cedarhacks/HIDMorph/electrical/silkscreen_v5_01.jpg

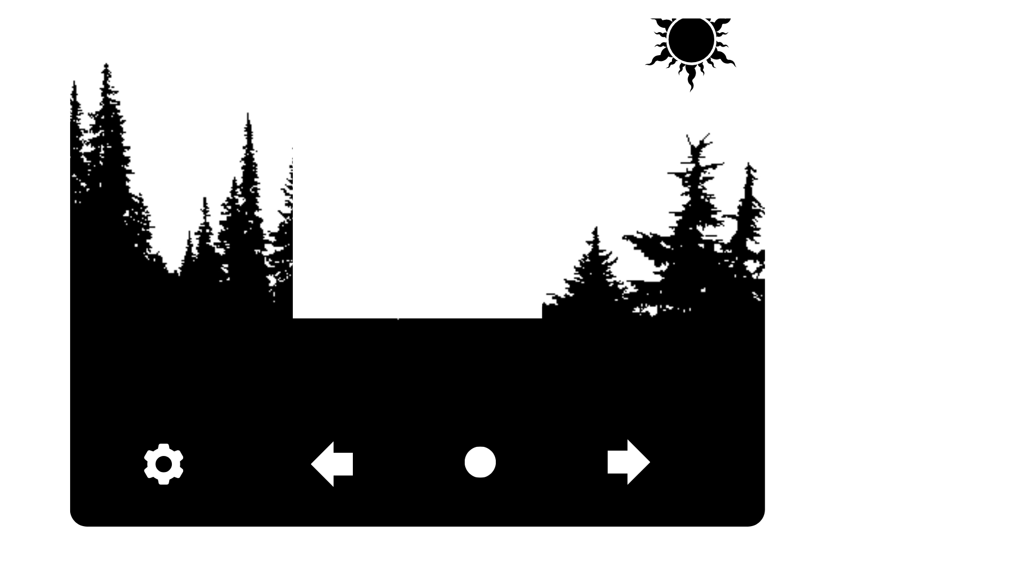
electrical/silkscreen_v5_01.jpg
