cedarhacks/HIDMorph/CH375B_breakout/BOM_CH37B Test Breakout_Schematic2_2025-04-11.xlsx

No. | Quantity | Comment | Designator | Footprint | Value | Manufacturer Part | Manufacturer | Supplier Part | Supplier
1 | 2 | PZ254-1-14-Z-8.5 | H1,H2 | HDR-TH_14P-P2.54-V-M |  | PZ254-1-14-Z-8.5 | HCTL(华灿天禄) | C2894937 | LCSC
2 | 1 | CH375B | U1 | SOIC-28_L17.9-W7.5-P1.27-LS10.3-BL |  | CH375B | WCH(南京沁恒) | C8962 | LCSC
