cedarhacks/HIDMorph/cad_files/screen_standoff.stl

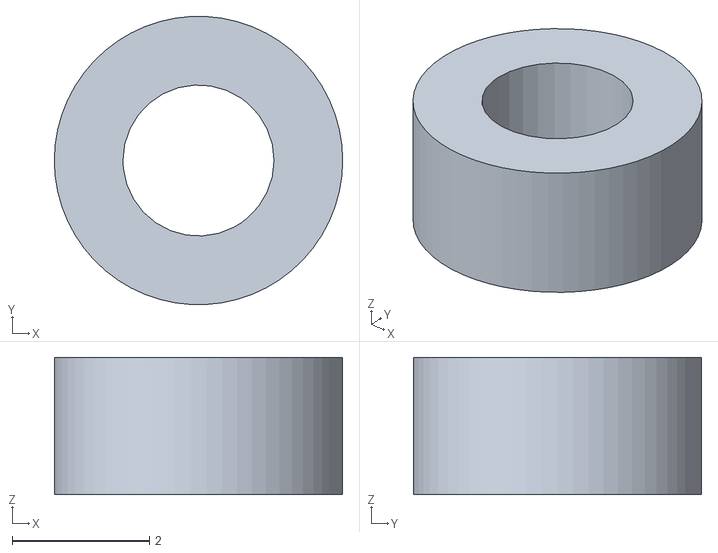
[picture p2: CAD file, 2026-01-06]
cad_files/screen_standoff.stl
4.20 x 4.19 x 2.00
