cedarhacks/HIDMorph/electrical/3D_models/ESP32-S3-WROOM-1-N8R8.STEP

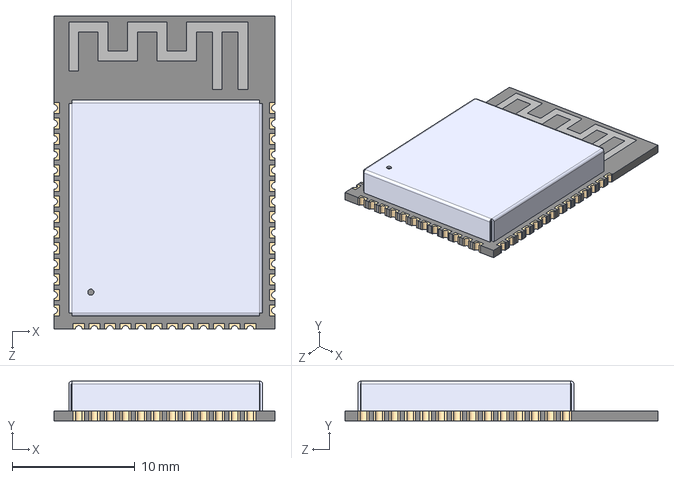
[picture p3: CAD file, 2025-07-15]
electrical/3D_models/ESP32-S3-WROOM-1-N8R8.STEP
18.0 x 3.25 x 25.5 mm
