cedarhacks/HIDMorph/electrical/edge_cut/v5.dxf

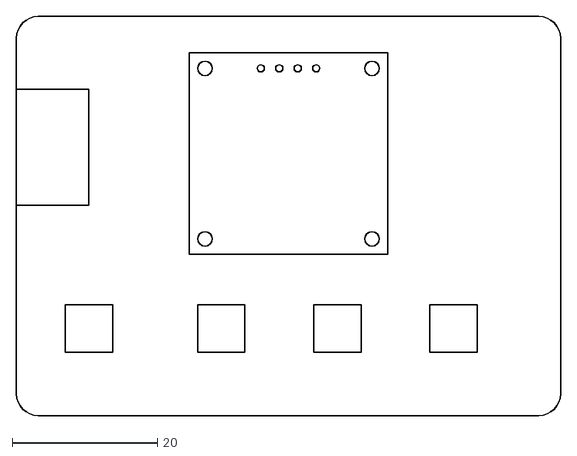
[picture p4: CAD file, 2025-12-17]
electrical/edge_cut/v5.dxf
75.0 x 55.0
