cedarhacks/HIDMorph/electrical/footprints/219-4MST.step

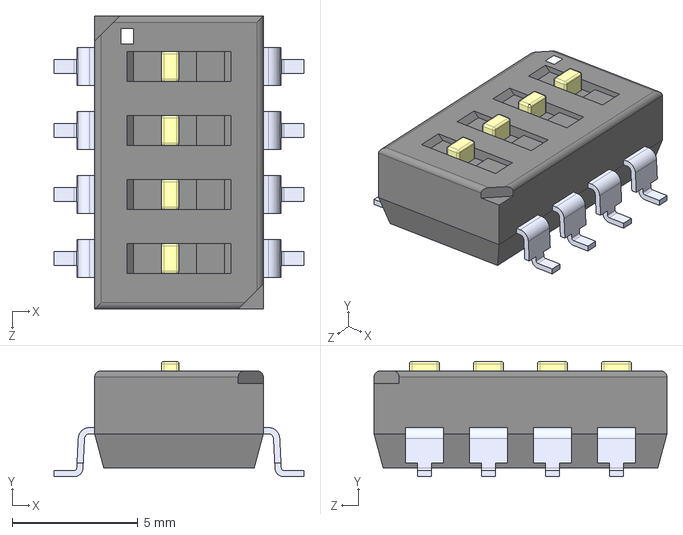
[picture p5: CAD file, 2025-12-18]
electrical/footprints/219-4MST.step
9.91 x 4.58 x 11.6 mm
