cedarhacks/HIDMorph/electrical/HIDMorph/ReMapper.step

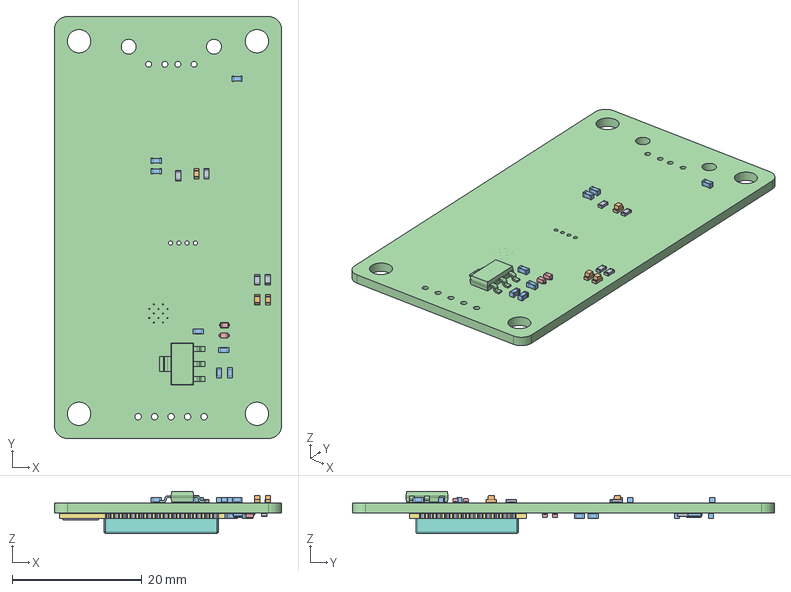
[picture p6: CAD file, 2025-10-05]
electrical/HIDMorph/ReMapper.step
35.0 x 65.0 x 6.48 mm
R_0603_1608Metric x 6
LED_0603_1608Metric x 3
C_0603_1608Metric x 14
SOT-223
D_SOD-523 x 4
ESP32-S3-WROOM-1
Crystal_SMD_3225-4Pin_3.2x2.5mm
ReMapper_PCB
