cedarhacks/HIDMorph/electrical/3D_models/RT6150B-33GQW.step

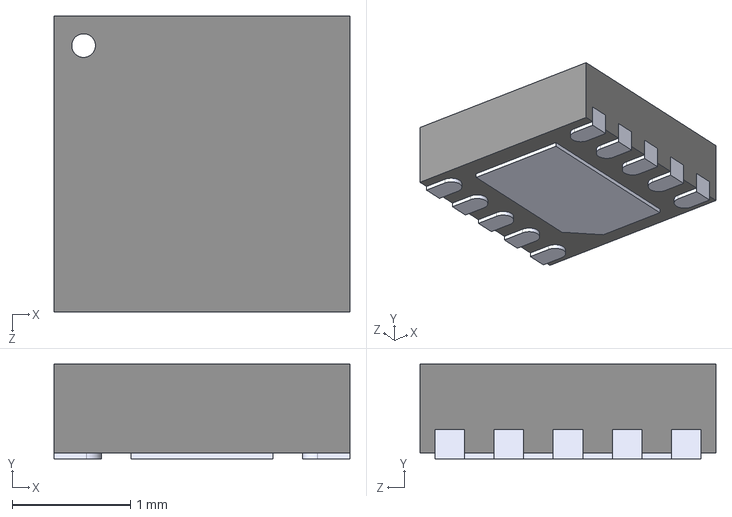
[picture p7: CAD file, 2025-07-15]
electrical/3D_models/RT6150B-33GQW.step
2.50 x 0.8 x 2.50 mm
