cedarhacks/HIDMorph/electrical/edge_cut/EdgeCut1.dxf

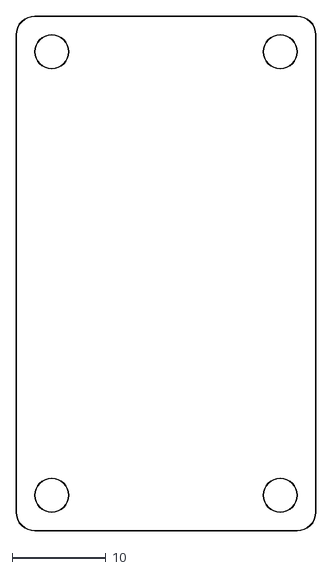
[picture p8: CAD file, 2025-09-18]
electrical/edge_cut/EdgeCut1.dxf
32.0 x 55.0
