cedarhacks/HIDMorph/electrical/footprints/SOT223-3_MXL.step

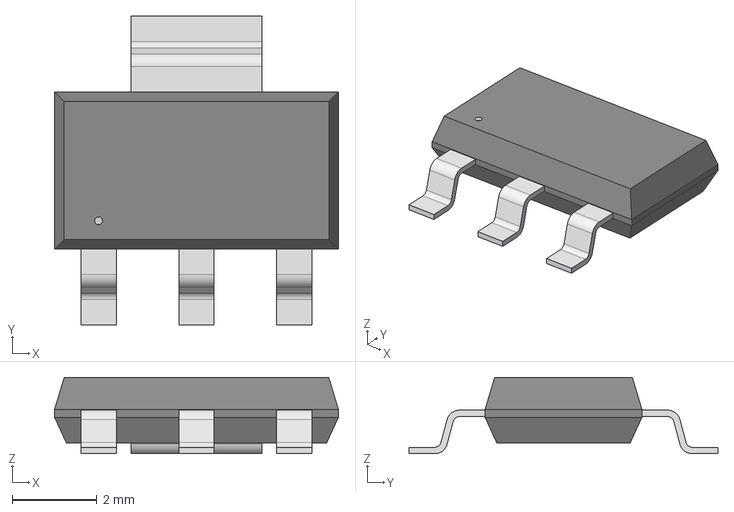
[picture p9: CAD file, 2025-07-15]
electrical/footprints/SOT223-3_MXL.step
6.71 x 7.29 x 1.81 mm
