cedarhacks/HIDMorph/electrical/3D_models/USBA_Female.step

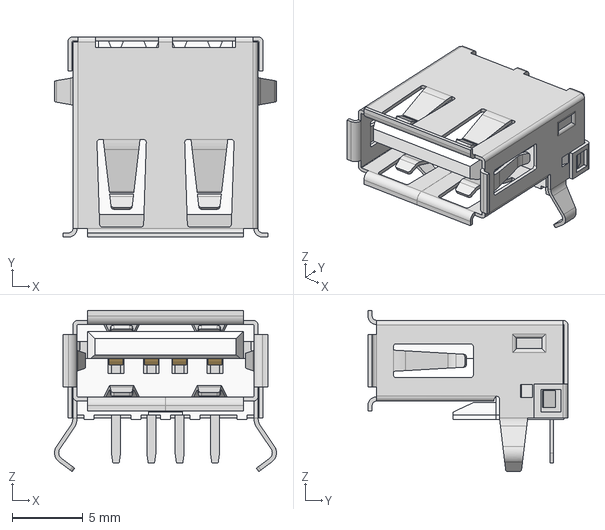
[picture p10: CAD file, 2025-07-15]
electrical/3D_models/USBA_Female.step
15.7 x 14.1 x 11.4 mm
614004190021_Shielding
