cedarhacks/HIDMorph/electrical/3D_models/push_button_SKRPABE010.step

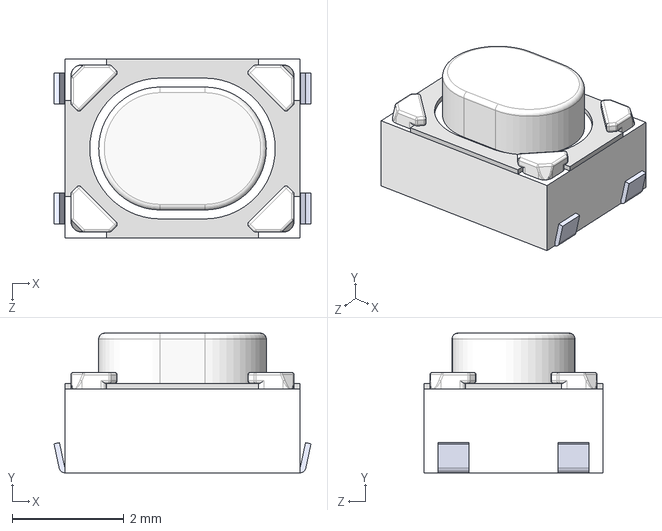
[picture p11: CAD file, 2025-07-15]
electrical/3D_models/push_button_SKRPABE010.step
4.60 x 2.50 x 3.20 mm
