cedarhacks/HIDMorph/electrical/3D_models/SC0914_13_.step

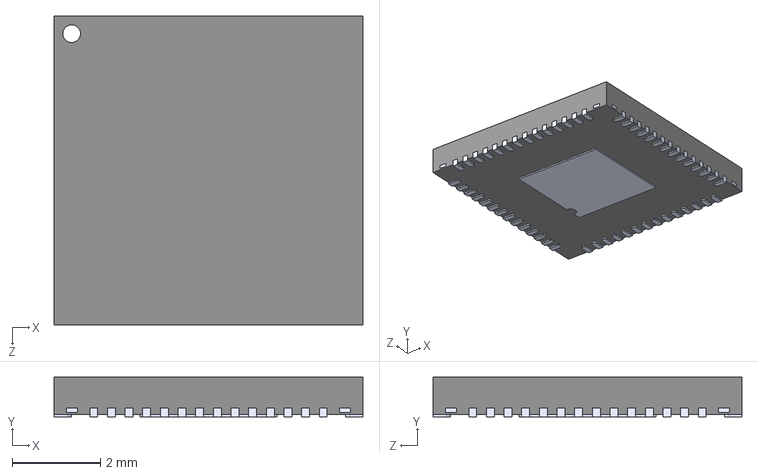
[picture p12: CAD file, 2025-07-15]
electrical/3D_models/SC0914_13_.step
7.00 x 0.9 x 7.00 mm
