cedarhacks/HIDMorph/electrical/HIDMorph/V2_schematic.pdf

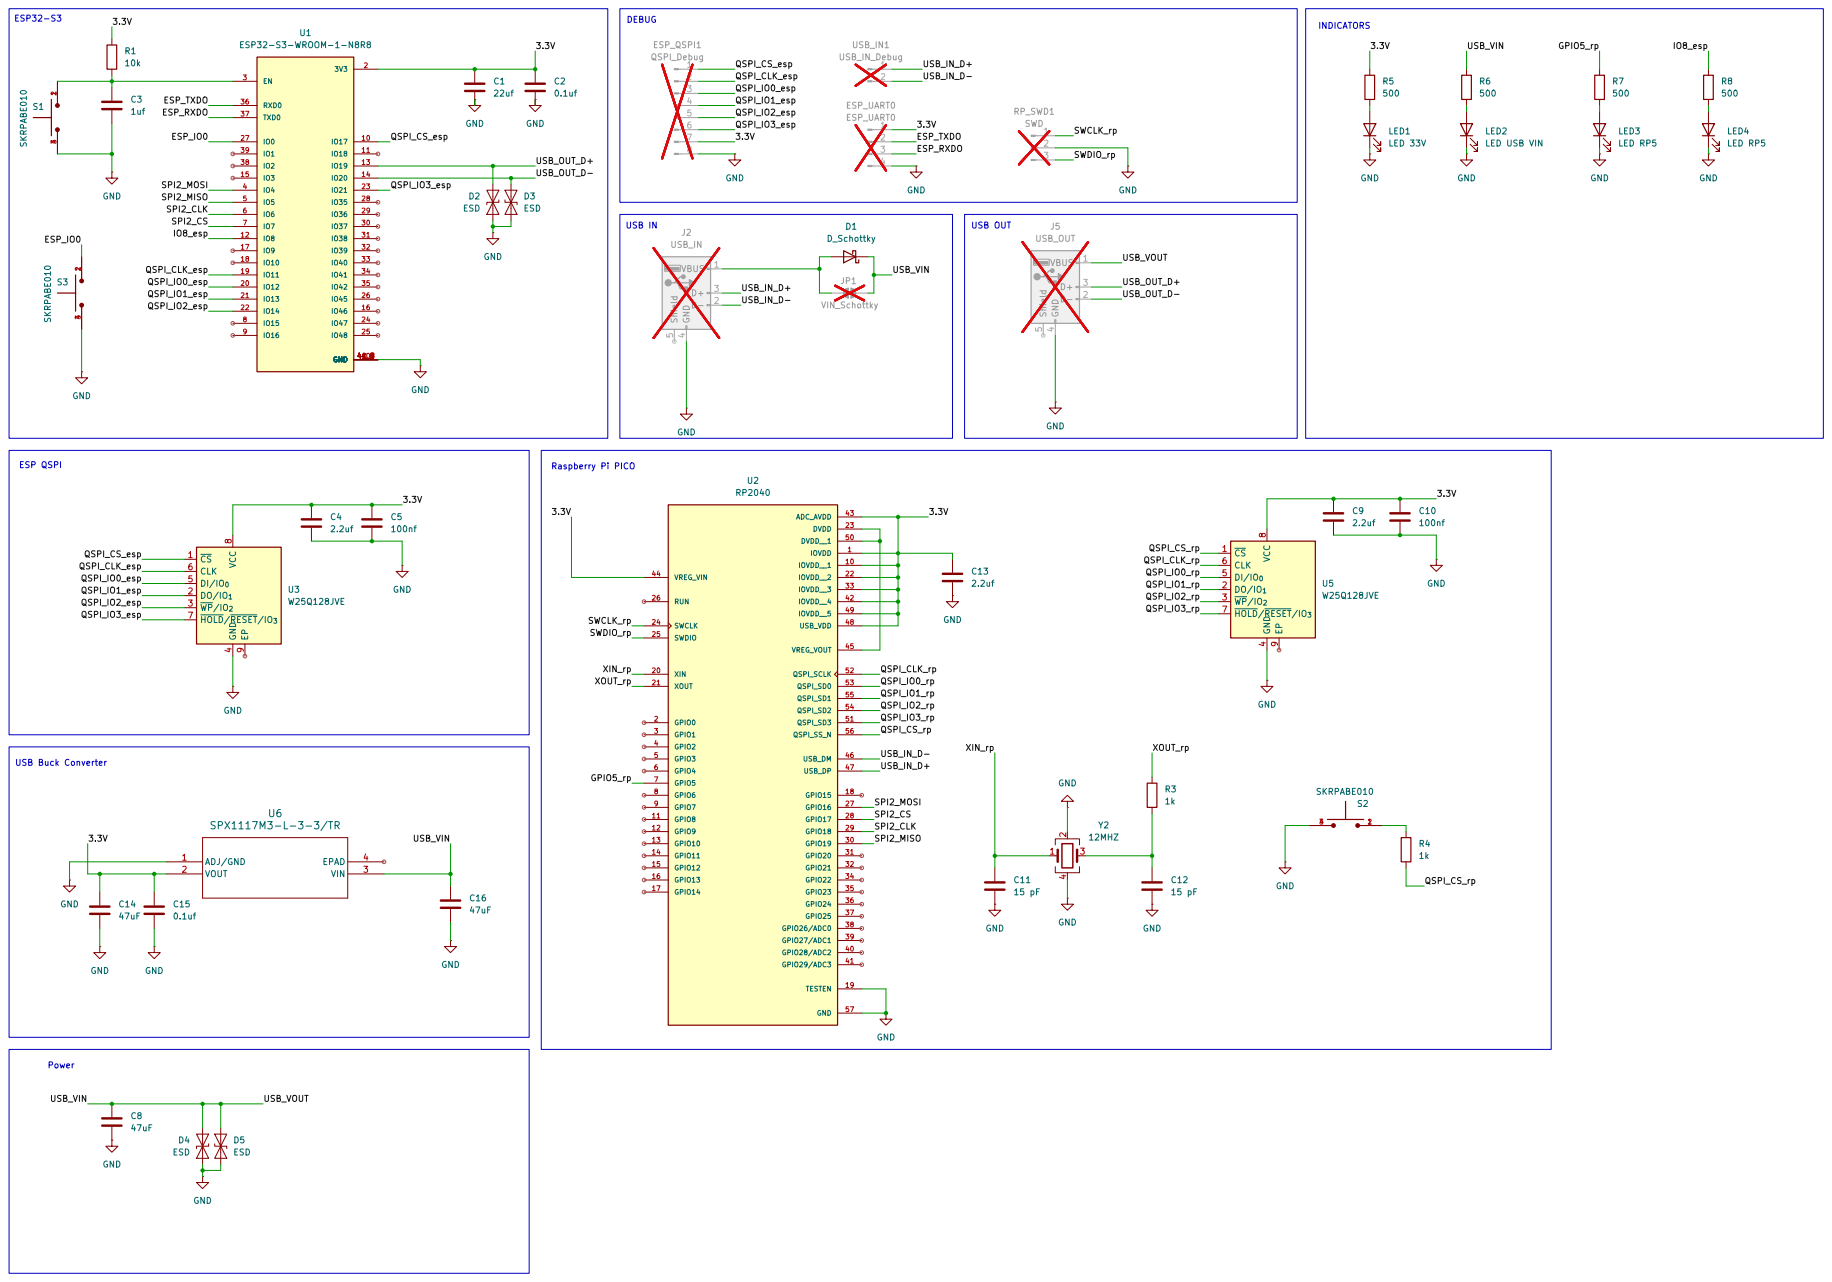
[picture p13: page 1]
