cedarhacks/HIDMorph/electrical/HIDMorph/assembly_map.pdf/HIDMorph-B_Cu.pdf

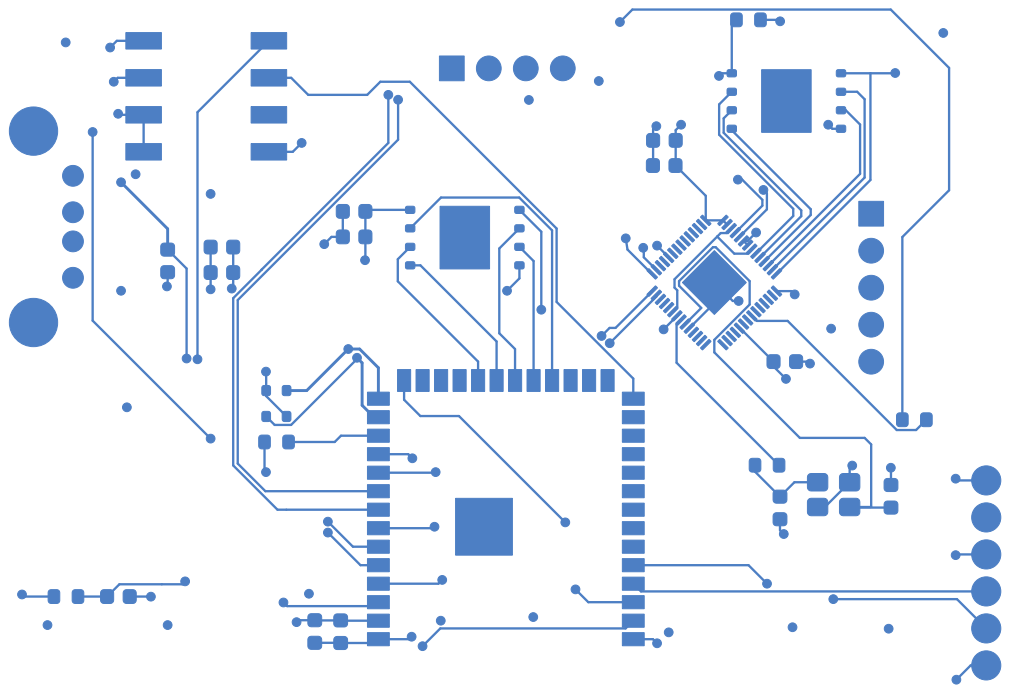
[picture p14: page 1]
