cedarhacks/HIDMorph/electrical/HIDMorph/assembly_map.pdf/HIDMorph-B_Mask.pdf

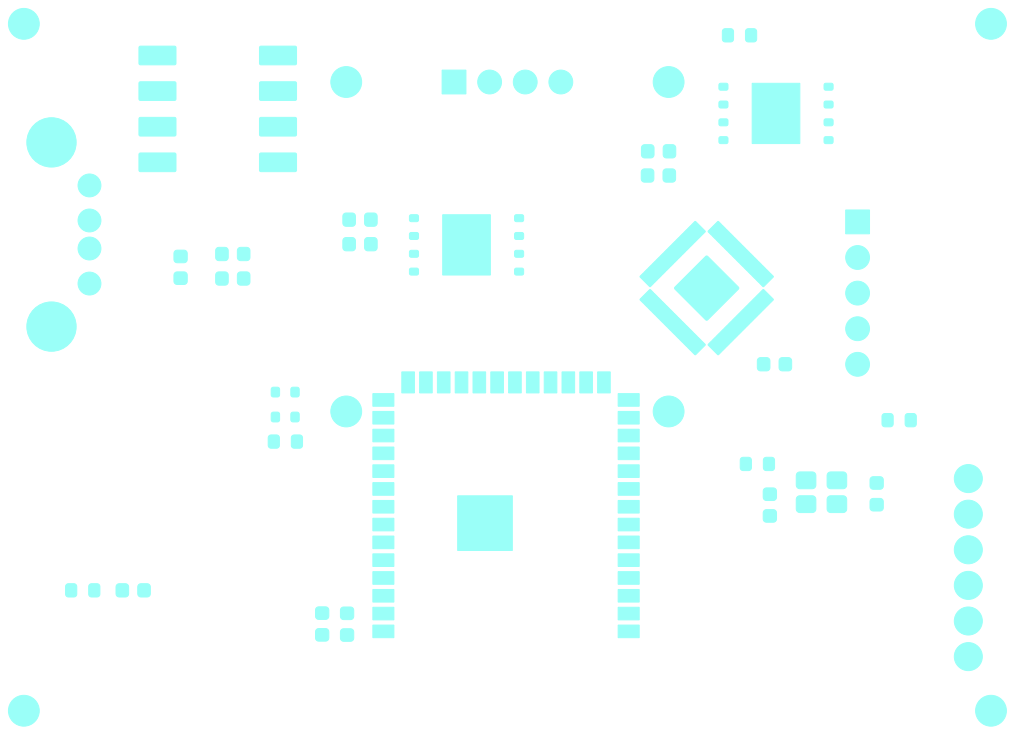
[picture p15: page 1]
