cedarhacks/HIDMorph/electrical/HIDMorph/assembly_map.pdf/HIDMorph-B_Paste.pdf

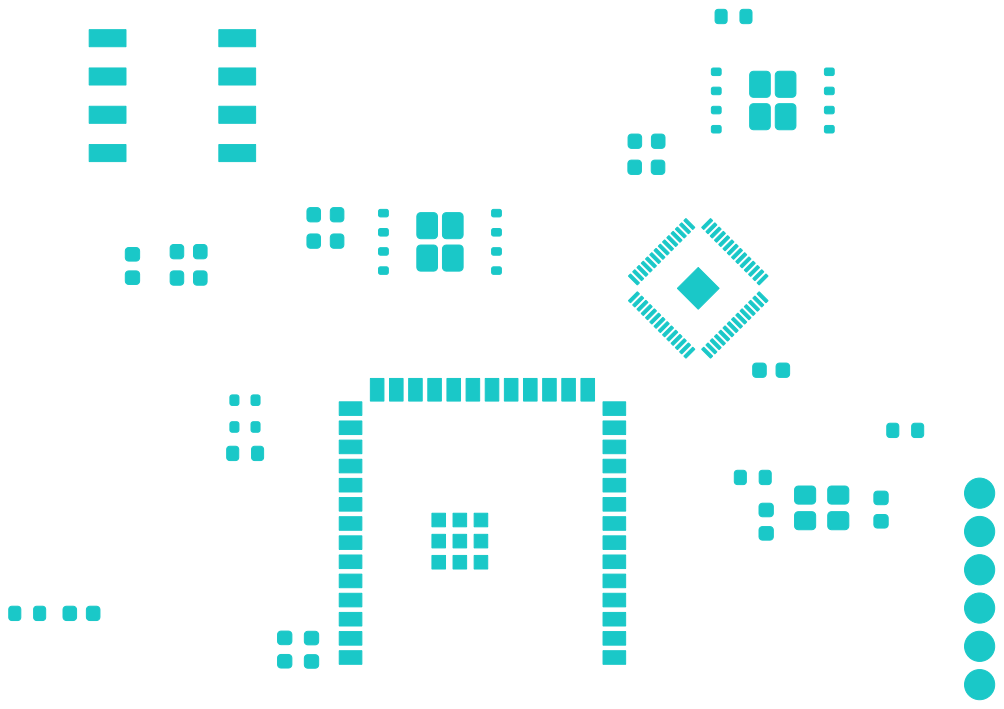
[picture p16: page 1]
