cedarhacks/HIDMorph/electrical/HIDMorph/assembly_map.pdf/HIDMorph-B_Silkscreen.pdf

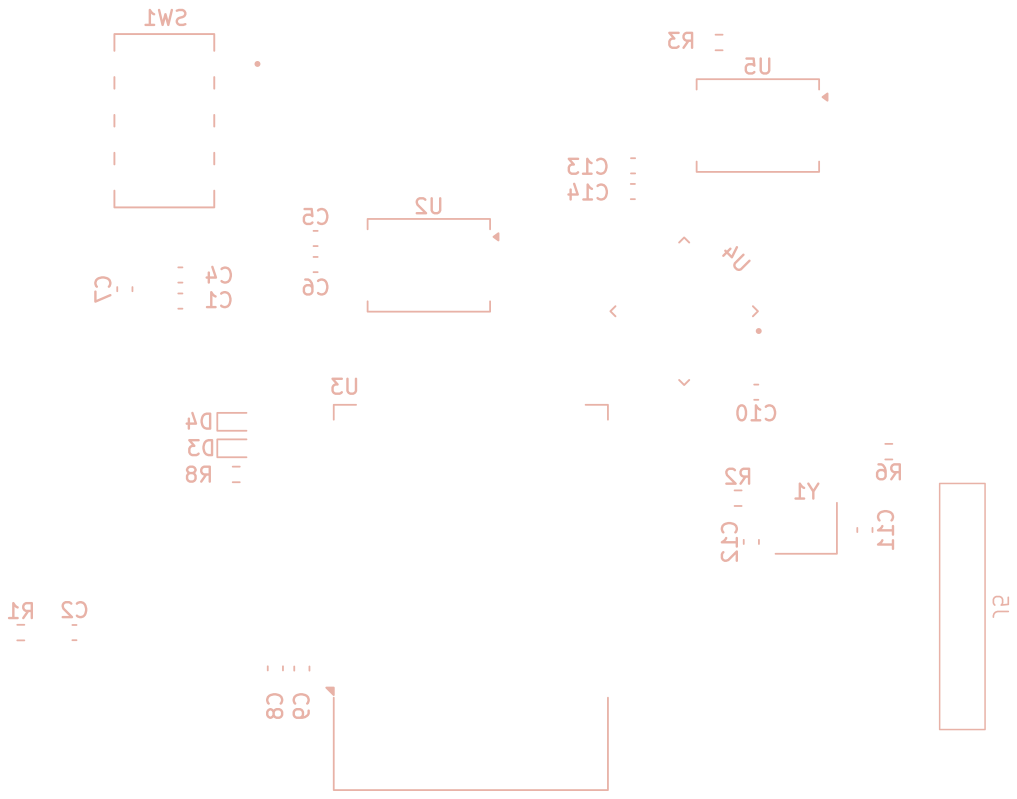
[picture p17: page 1]
