cedarhacks/HIDMorph/electrical/HIDMorph/assembly_map.pdf/HIDMorph-Edge_Cuts.pdf

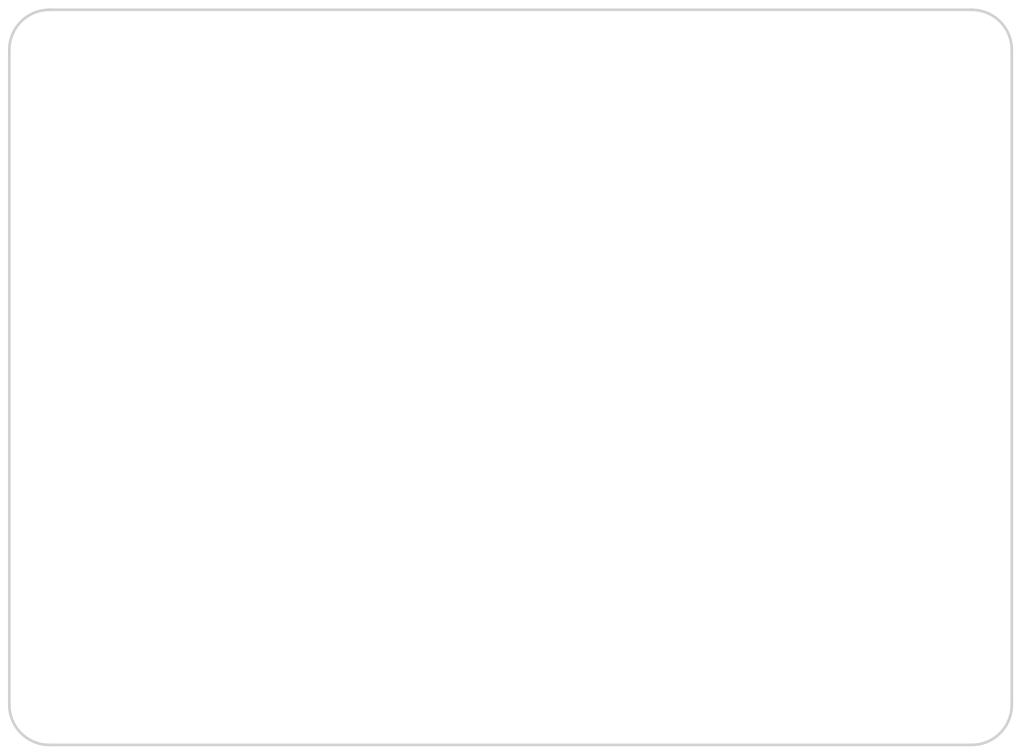
[picture p18: page 1]
