cedarhacks/HIDMorph/electrical/HIDMorph/V2_layout.pdf

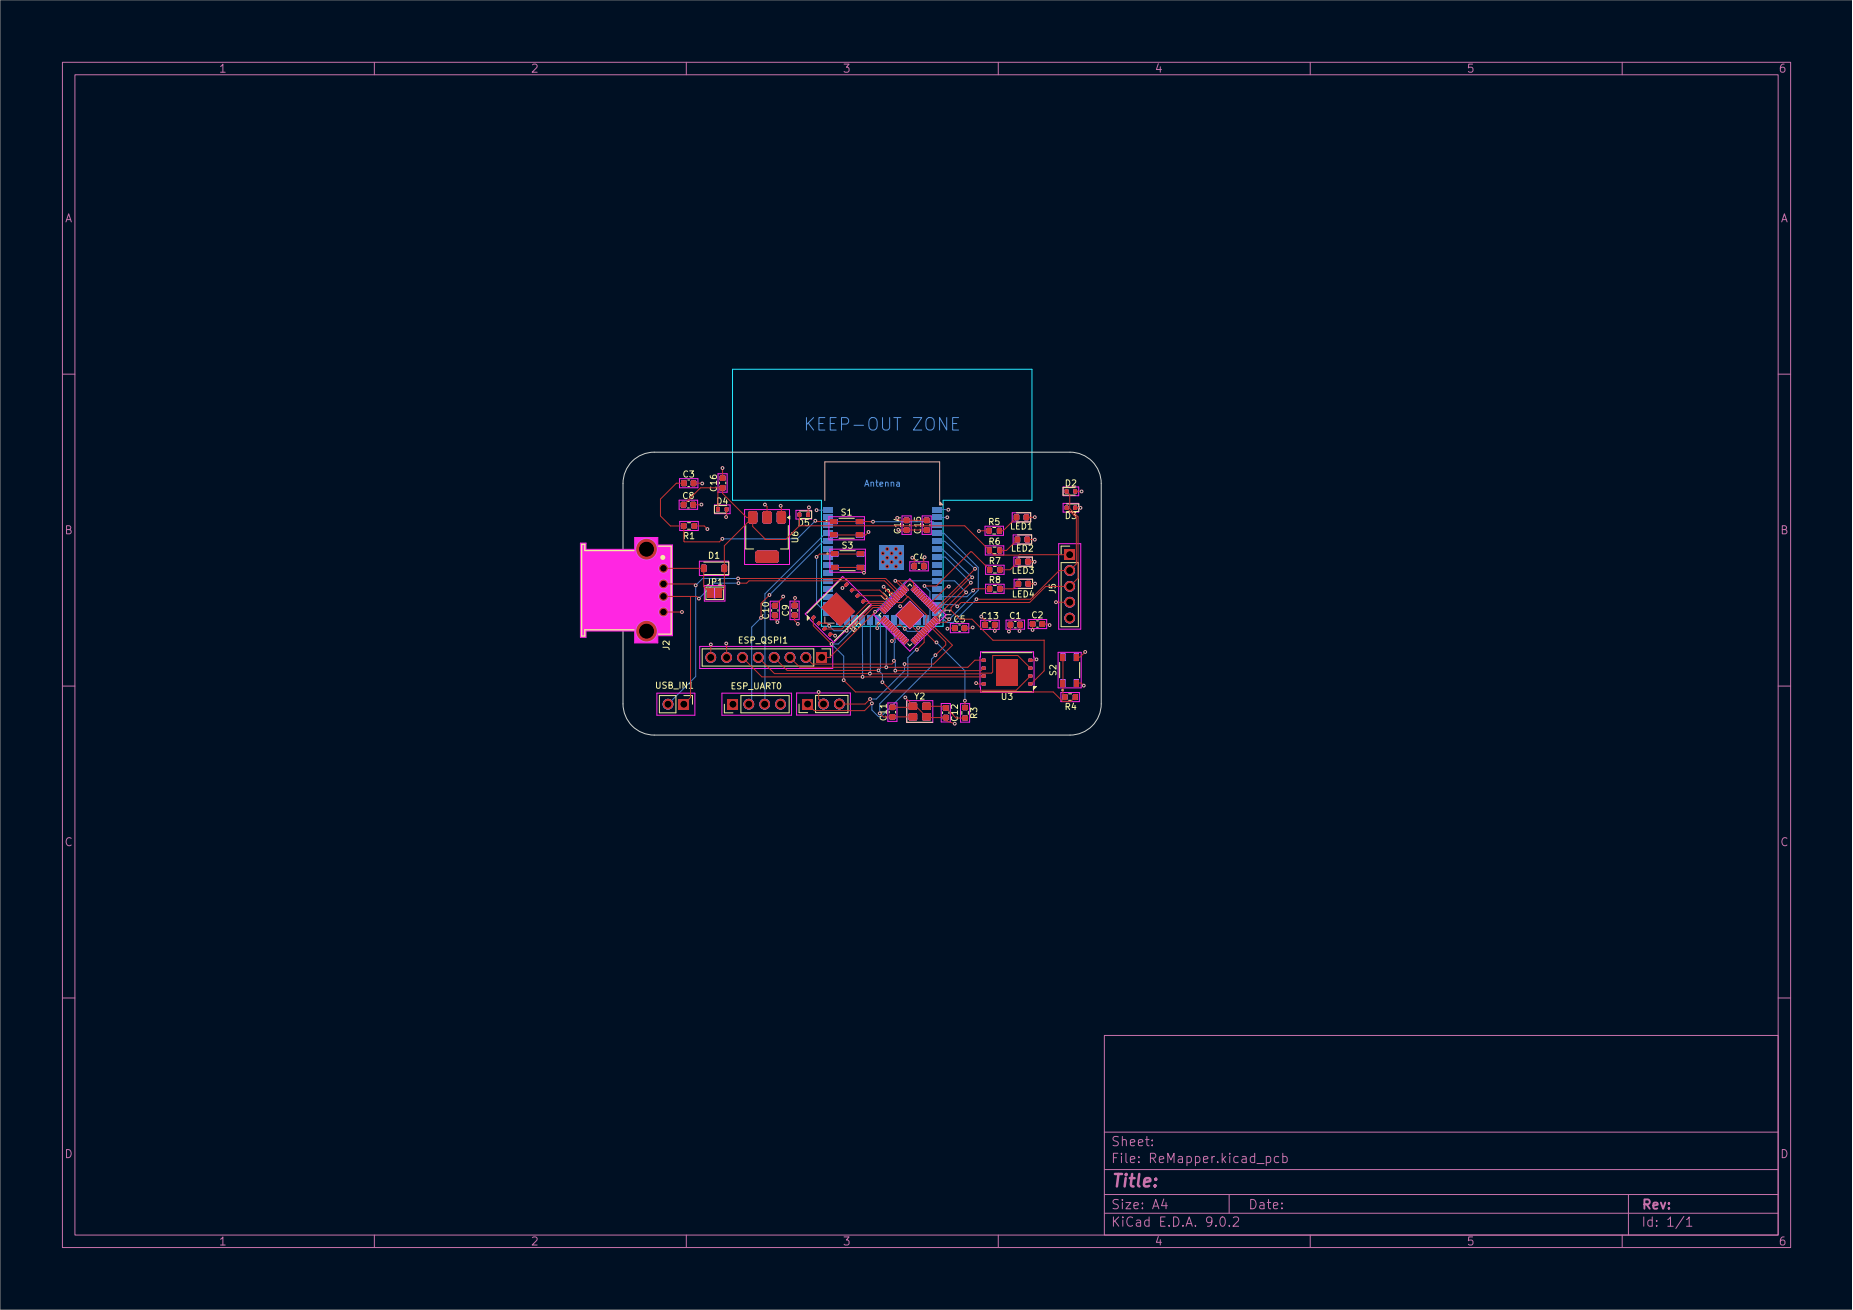
[picture p19: page 1]
