cedarhacks/HIDMorph/(list of files, drawings)

Other design files:
CH375B_breakout/KeyStick_2025-04-11.epro
HT42B564-Breakout/HT42B564-breakout.epro
