cedarhacks/HIDMorph/electrical/HIDMorph/HIDMorph.kicad_pcb

## KiCad design electrical/HIDMorph/HIDMorph.kicad_pcb (2026-01-06)

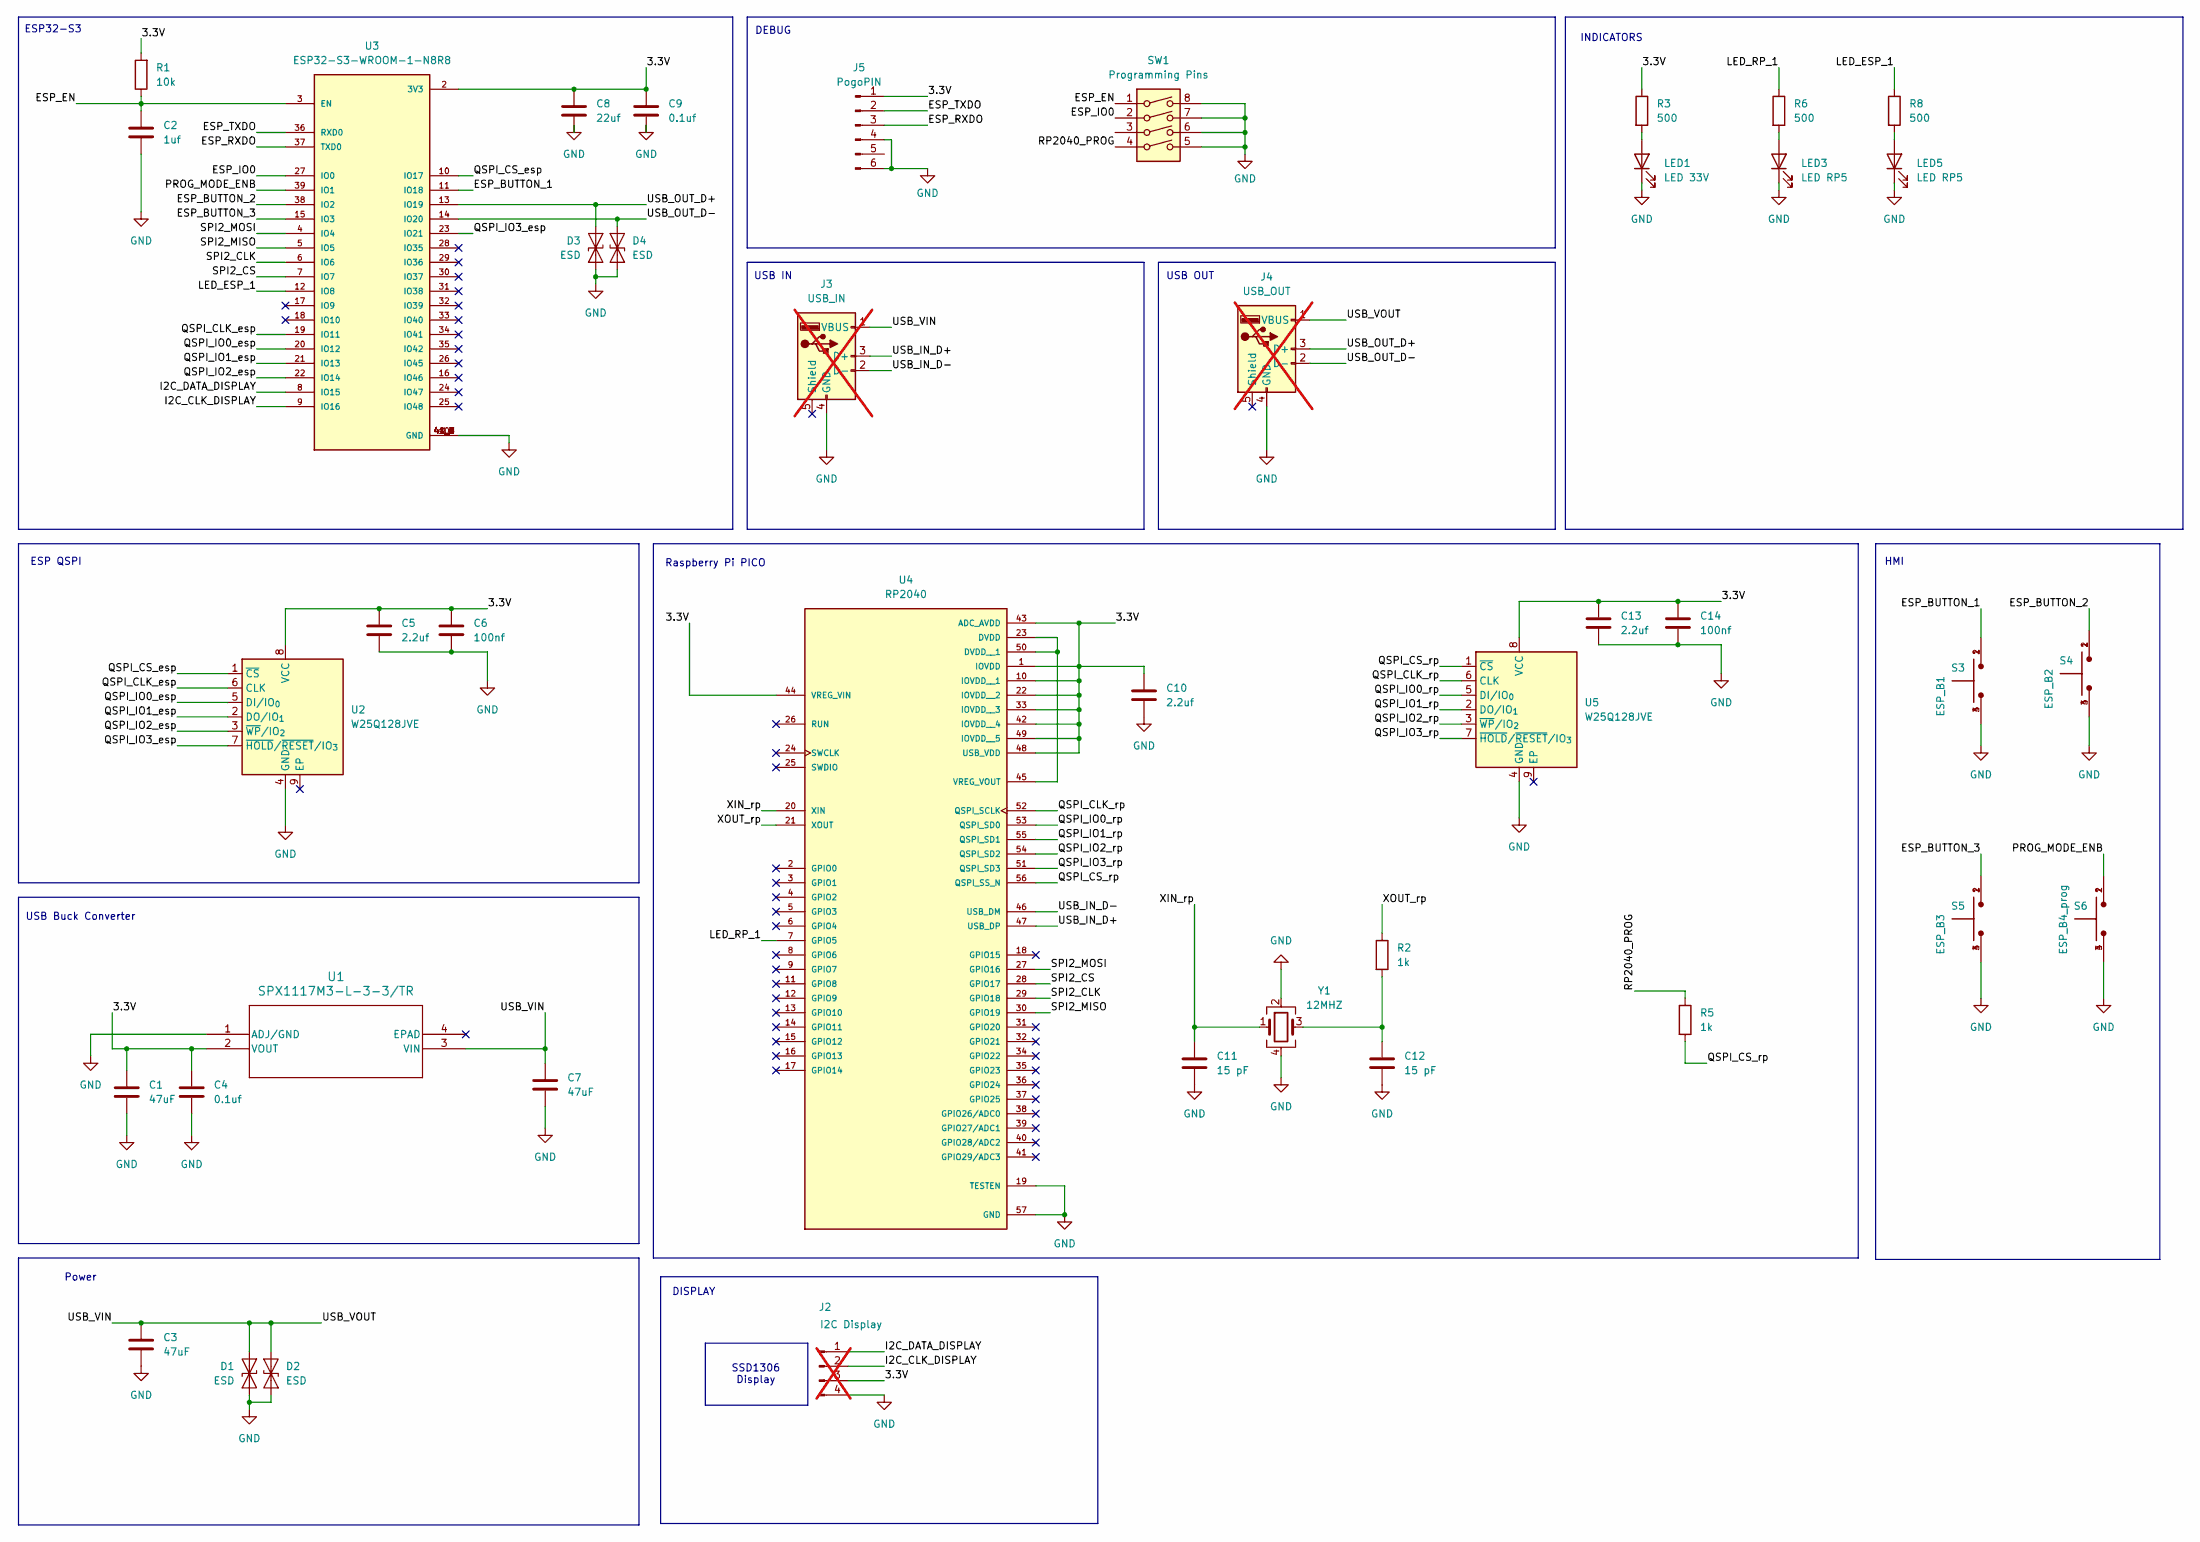
[picture p20: schematic HIDMorph.kicad_sch]

Parts:
C1, C3, C7: 47uF; C_0603_1608Metric; LCSC Part C140782
C2: 1uf; C_0603_1608Metric; LCSC Part C5189821
C4, C9: 0.1uf; C_0603_1608Metric; LCSC Part C14663
C5, C10, C13: 2.2uf; C_0603_1608Metric; LCSC Part C5189830
C6, C14: 100nf; C_0603_1608Metric; LCSC Part C5189821
C8: 22uf; C_0603_1608Metric; LCSC Part C48579267
C11, C12: 15 pF; C_0603_1608Metric; LCSC Part C107037
D1, D2, D3, D4: ESD; D_SOD-523; LCSC Part C5199159
J2: I2C Display; PinHeader_1x04_P2.54mm_Vertical; not fitted
J3: USB_IN; USBA_Female; not fitted
J4: USB_OUT; PinHeader_1x05_P2.54mm_Vertical; not fitted
J5: PogoPIN; pogo_pin_2.54mm
LED1: LED 33V; LED_0603_1608Metric; LCSC Part C965807
LED3, LED5: LED RP5; LED_0603_1608Metric; LCSC Part C965807
R1: 10k; R_0603_1608Metric; LCSC Part C98220
R2, R5: 1k; R_0603_1608Metric; LCSC Part C22548
R3, R6, R8: 500; R_0603_1608Metric; LCSC Part C860931
S3: ESP_B1; SW-SMD_4P-L4.5-W4.5-P3.00-LS6.8; LCSC Part C2837554
S4: ESP_B2; SW-SMD_4P-L4.5-W4.5-P3.00-LS6.8; LCSC Part C2837554
S5: ESP_B3; SW-SMD_4P-L4.5-W4.5-P3.00-LS6.8; LCSC Part C2837554
S6: ESP_B4_prog; SW-SMD_4P-L4.5-W4.5-P3.00-LS6.8; LCSC Part C2837554
SW1: Programming Pins; SW_DIP_219-4
U1: SPX1117M3-L-3-3/TR; SOT-223; LCSC Part C6862
U2, U5: W25Q128JVE; WSON-8-1EP_8x6mm_P1.27mm_EP3.4x4.3mm; LCSC Part C401662
U3: ESP32-S3-WROOM-1-N8R8; ESP32-S3-WROOM-1; LCSC Part C2913201
U4: RP2040; rp2040; PARTREV 2.2; LCSC Part C2040
Y1: 12MHZ; Crystal_SMD_3225-4Pin_3.2x2.5mm; LCSC Part C9002

Connections:
/3.3V: C1.1, C4.1, C5.1, C6.1, C8.1, C9.1, C10.1, C13.1, C14.1, J2.3, J5.1, R1.2, R3.1, U1.2 (VOUT), U2.8 (VCC), U3.2 (3V3), U4.1 (IOVDD), U4.10 (IOVDD__1), U4.22 (IOVDD__2), U4.33 (IOVDD__3), U4.42 (IOVDD__4), U4.43 (ADC_AVDD), U4.44 (VREG_VIN), U4.48 (USB_VDD), U4.49 (IOVDD__5), U5.8 (VCC)
/ESP_BUTTON_1: S3.1, S3.2, U3.11 (IO18)
/ESP_BUTTON_2: S4.1, S4.2, U3.38 (IO2)
/ESP_BUTTON_3: S5.1, S5.2, U3.15 (IO3)
/ESP_EN: C2.1, R1.1, SW1.1, U3.3 (EN)
/ESP_IO0: SW1.2, U3.27 (IO0)
/ESP_RXDO: J5.3, U3.37 (TXD0)
/ESP_TXDO: J5.2, U3.36 (RXD0)
/I2C_CLK_DISPLAY: J2.2, U3.9 (IO16)
/I2C_DATA_DISPLAY: J2.1, U3.8 (IO15)
/LED_ESP_1: R8.1, U3.12 (IO8)
/LED_RP_1: R6.1, U4.7 (GPIO5)
/PROG_MODE_ENB: S6.1, S6.2, U3.39 (IO1)
/QSPI_CLK_esp: U2.6 (CLK), U3.19 (IO11)
/QSPI_CLK_rp: U4.52 (QSPI_SCLK), U5.6 (CLK)
/QSPI_CS_esp: U2.1 (~CS), U3.10 (IO17)
/QSPI_CS_rp: R5.2, U4.56 (QSPI_SS_N), U5.1 (~CS)
/QSPI_IO0_esp: U2.5 (DI/IO_{0}), U3.20 (IO12)
/QSPI_IO0_rp: U4.53 (QSPI_SD0), U5.5 (DI/IO_{0})
/QSPI_IO1_esp: U2.2 (DO/IO_{1}), U3.21 (IO13)
/QSPI_IO1_rp: U4.55 (QSPI_SD1), U5.2 (DO/IO_{1})
/QSPI_IO2_esp: U2.3 (~WP/IO_{2}), U3.22 (IO14)
/QSPI_IO2_rp: U4.54 (QSPI_SD2), U5.3 (~WP/IO_{2})
/QSPI_IO3_esp: U2.7 (~HOLD/~RESET/IO_{3}), U3.23 (IO21)
/QSPI_IO3_rp: U4.51 (QSPI_SD3), U5.7 (~HOLD/~RESET/IO_{3})
/RP2040_PROG: R5.1, SW1.4
/SPI2_CLK: U3.6 (IO6), U4.29 (GPIO18)
/SPI2_CS: U3.7 (IO7), U4.28 (GPIO17)
/SPI2_MISO: U3.5 (IO5), U4.30 (GPIO19)
/SPI2_MOSI: U3.4 (IO4), U4.27 (GPIO16)
/USB_IN_D+: J3.3 (D+), U4.47 (USB_DP)
/USB_IN_D-: J3.2 (D-), U4.46 (USB_DM)
/USB_OUT_D+: D3.1 (A1), J4.3 (D+), U3.13 (IO19)
/USB_OUT_D-: D4.2 (A2), J4.2 (D-), U3.14 (IO20)
/USB_VIN: C3.1, C7.1, D1.1 (A1), D2.2 (A2), J3.1 (VBUS), J4.1 (VBUS), U1.3 (VIN)
/XIN_rp: C11.1, U4.20 (XIN), Y1.1
/XOUT_rp: R2.1, U4.21 (XOUT)
GND: C1.2, C2.2, C3.2, C4.2, C5.2, C6.2, C7.2, C8.2, C9.2, C10.2, C11.2, C12.2, C13.2, C14.2, D1.2 (A2), D2.1 (A1), D3.2 (A2), D4.1 (A1), J2.4, J3.4 (GND), J4.4 (GND), J5.4, J5.6, LED1.1 (K), LED3.1 (K), LED5.1 (K), S3.3, S3.4, S4.3, S4.4, S5.3, S5.4, S6.3, S6.4, SW1.5, SW1.6, SW1.7, SW1.8, U1.1 (ADJ/GND), U2.4 (GND), U3.1 (GND), U3.40 (GND), U3.41_1 (GND), U3.41_2 (GND), U3.41_3 (GND), U3.41_4 (GND), U3.41_5 (GND), U3.41_6 (GND), U3.41_7 (GND), U3.41_8 (GND), U3.41_9 (GND), U4.19 (TESTEN), U4.57 (GND), U5.4 (GND), Y1.2, Y1.4
unnamed: C12.1, R2.2, Y1.3
unnamed: LED1.2 (A), R3.2
unnamed: LED3.2 (A), R6.2
unnamed: LED5.2 (A), R8.2
unnamed: U4.23 (DVDD), U4.45 (VREG_VOUT), U4.50 (DVDD__1)

Notes on the sheet:
INDICATORS
USB IN
DISPLAY
ESP QSPI
USB Buck Converter
Power
USB OUT
Raspberry Pi PICO
ESP32-S3
HMI
SSD1306 Display
DEBUG

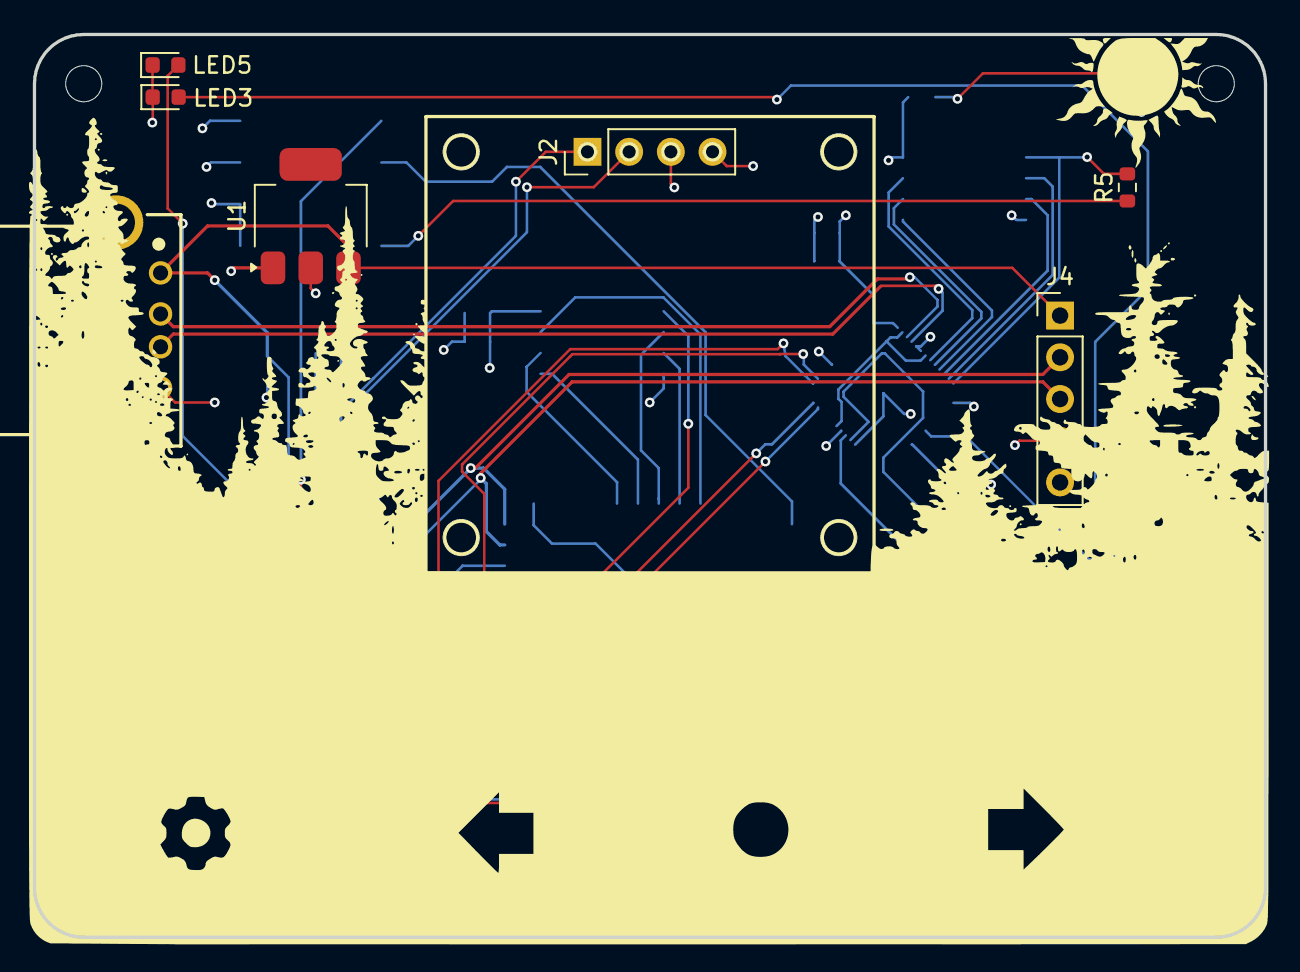
[picture p21: board HIDMorph.kicad_pcb from above]

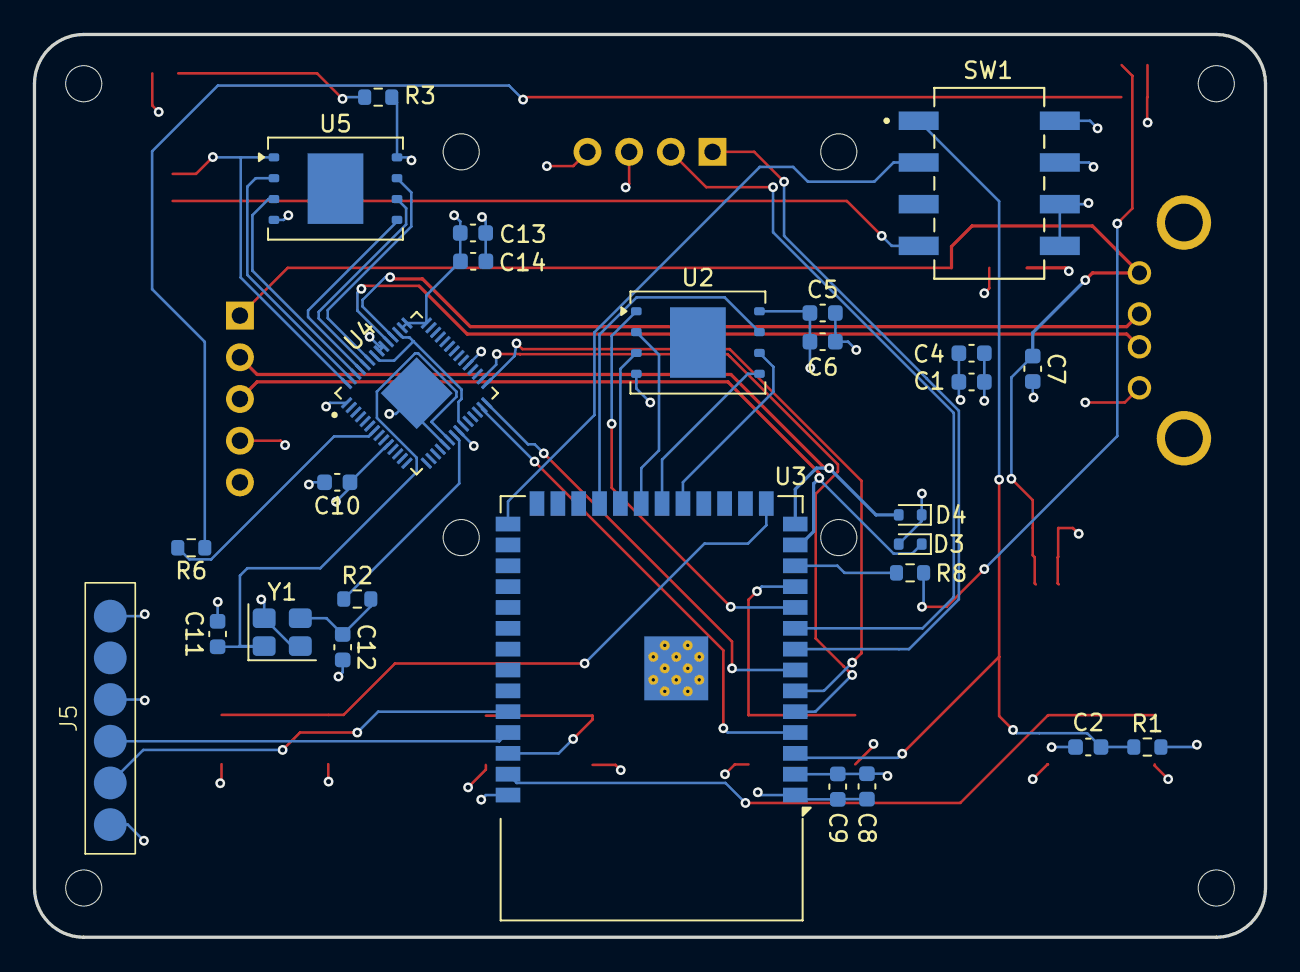
[picture p22: board HIDMorph.kicad_pcb from below]

Board: 4 copper layers, 75.0 x 55.0 mm, 42 parts (27 on the bottom side), 43 nets.
