cedarhacks/HIDMorph/software/ESP32/HIDMorph/main/src/webserver.c

#include "webserver.h"

#include <string.h>

#include "lwip/sockets.h"
#include "lwip/netdb.h"
#include "lwip/inet.h"
#include "esp_log.h"

#define DNS_PORT 53
#define DNS_BUFFER_SIZE 512
int dns_sock;

extern const uint8_t _binary_index_html_start[];
extern const uint8_t _binary_index_html_end[];

extern const uint8_t _binary_style_css_start[];
extern const uint8_t _binary_style_css_end[];

void start_access_point() {

    // Initialize NVS
    ESP_ERROR_CHECK(nvs_flash_init());
    ESP_ERROR_CHECK(esp_netif_init());
    ESP_ERROR_CHECK(esp_event_loop_create_default());

    esp_netif_create_default_wifi_ap();

    wifi_init_config_t cfg = WIFI_INIT_CONFIG_DEFAULT();
    ESP_ERROR_CHECK(esp_wifi_init(&cfg));

    wifi_config_t wifi_config = {
        .ap = {
            .ssid = AP_SSID,
            .ssid_len = strlen(AP_SSID),
            .password = AP_PASSWD,
            .max_connection = 4,
            .authmode = WIFI_AUTH_WPA_WPA2_PSK},
    };

    // no auth
    wifi_config.ap.authmode = WIFI_AUTH_OPEN;

    ESP_ERROR_CHECK(esp_wifi_set_mode(WIFI_MODE_AP));
    ESP_ERROR_CHECK(esp_wifi_set_config(WIFI_IF_AP, &wifi_config));
    ESP_ERROR_CHECK(esp_wifi_start());

    ESP_LOGI("WIFI", "Wifi network started: %s\n", AP_SSID);
}

// -------------------------------------------------------------------------------------

esp_err_t root_get_handler(httpd_req_t *req) {
    const char *resp_str = (char*)_binary_index_html_start;
    httpd_resp_send(req, resp_str, HTTPD_RESP_USE_STRLEN);
    return ESP_OK;
}

esp_err_t style_get_handler(httpd_req_t *req) {
    const char *resp_str = (char*)_binary_style_css_start;
    httpd_resp_send(req, resp_str, HTTPD_RESP_USE_STRLEN);
    return ESP_OK;
}

void start_webserver() {
    httpd_config_t config = HTTPD_DEFAULT_CONFIG();

    httpd_handle_t server = NULL;

    httpd_uri_t uri_root = {.uri = "/",
                            .method = HTTP_GET,
                            .handler = root_get_handler,
                            .user_ctx = NULL};

    httpd_uri_t uri_style = {.uri = "/style.css",
                             .method = HTTP_GET,
                             .handler = style_get_handler,
                             .user_ctx = NULL};

    if (httpd_start(&server, &config) == ESP_OK) {
        httpd_register_uri_handler(server, &uri_root);
        httpd_register_uri_handler(server, &uri_style);
    }

    ESP_LOGI("WebServer", "HTTP server started!\n");
}

void start_dns() {
    struct sockaddr_in server_addr;
    dns_sock = socket(AF_INET, SOCK_DGRAM, IPPROTO_UDP);

    if (dns_sock < 0) {
        ESP_LOGE("[HIDMorph DNS]", "Socket creation failed");
        return;
    }

    memset(&server_addr, 0, sizeof(server_addr));
    server_addr.sin_family = AF_INET;
    server_addr.sin_addr.s_addr = htonl(INADDR_ANY);
    server_addr.sin_port = htons(DNS_PORT);

    bind(dns_sock, (struct sockaddr *)&server_addr, sizeof(server_addr));
    ESP_LOGI("[HIDMorph DNS]", "DNS server started on port %d", DNS_PORT);
}

void step_dns() {
    struct sockaddr_in client_addr;
    socklen_t sock_len = sizeof(client_addr);
    static uint8_t dns_buf[DNS_BUFFER_SIZE];

    int len = recvfrom(dns_sock, dns_buf, DNS_BUFFER_SIZE, 0, (struct sockaddr *)&client_addr, &sock_len);
    if (len < 0) return;

    // Craft a minimal DNS response to any query
    // This is a simple fixed format response
    dns_buf[2] |= 0x80; // Set response flag
    dns_buf[3] |= 0x80; // Set recursion available
    dns_buf[7] = 1;     // Answer count

    // Add answer section
    int pos = len;
    dns_buf[pos++] = 0xC0;
    dns_buf[pos++] = 0x0C; // pointer to domain name
    dns_buf[pos++] = 0x00;
    dns_buf[pos++] = 0x01; // type A
    dns_buf[pos++] = 0x00;
    dns_buf[pos++] = 0x01; // class IN
    dns_buf[pos++] = 0x00;
    dns_buf[pos++] = 0x00;
    dns_buf[pos++] = 0x00;
    dns_buf[pos++] = 0x3C; // TTL
    dns_buf[pos++] = 0x00;
    dns_buf[pos++] = 0x04; // data length

    // Set IP: 192.168.4.1 (default ESP32 AP IP)
    dns_buf[pos++] = 192;
    dns_buf[pos++] = 168;
    dns_buf[pos++] = 4;
    dns_buf[pos++] = 1;

    sendto(dns_sock, dns_buf, pos, 0, (struct sockaddr *)&client_addr, sock_len);
}

void webserver_init() {

    start_access_point();
    start_webserver();
    start_dns();

    while (1) {
        step_dns();
    }
}

void webserver_step() {
}
