cedarhacks/HIDMorph/(commit log)

2025-07-15 added V1 Files post fab
    [BOM_CH37B Test Breakout_Schematic2_2025-04-11.xlsx, ESP32-S3-WROOM-1-N8R8.STEP, HT42B564-breakout.epro, KeyStick_2025-04-11.epro, PickAndPlace_PCB2_2025-04-11.xlsx, RT6150B-33GQW.step, ReMapper.kicad_pcb, ReMapper.kicad_sch]
2025-09-06 mounting as fatfs with vfs and wear levelling
2025-09-09 Made it work as a usb MSC device in programming mode
2025-09-10 working now as MSC and HID device selectively
2025-09-12 gpio programming mode
    [ReMapper.kicad_sch]
2025-09-17 modified schematic to reflect i2c screen, 3 new buttons and 1 new switch
    [ReMapper.kicad_sch]
2025-09-18 schematic update, pcb design rules and blank slate on pcb editor
    [ReMapper.kicad_pcb, ReMapper.kicad_sch]
2025-09-18 started work on V3
    [EdgeCut1.dwg, EdgeCut1.dxf, ReMapper.kicad_pcb, ReMapper.kicad_sch]
2025-09-19 more component placement, removed lots of debug and hmi
    [ReMapper.kicad_pcb, ReMapper.kicad_sch]
2025-09-19 first layout attempt, had to compromise on some SMD and shrink the header pins
    [ReMapper.kicad_pcb, ReMapper.kicad_sch]
2025-09-19 It ssems too small, I need some space for trace highways
    [ReMapper.kicad_pcb, ReMapper.kicad_sch]
2025-09-20 way happier with this layout
    [ReMapper.kicad_pcb, edge_cut_65x35.dxf]
2025-09-20 only warnings left on DRC
    [ReMapper.kicad_pcb]
2025-09-20 drc passed, added silkscreen
    [ReMapper.kicad_pcb]
2025-09-20 working on fab
    [ReMapper.kicad_pcb, ReMapper.kicad_sch, bom.csv, designators.csv, positions.csv]
2025-09-20 V3 to fab
    [ReMapper.kicad_pcb, bom.csv, positions.csv]
2025-10-08 error check sometimes fails due to data4... im not sure
    [W25Q128J.c]
2025-10-08 started working gui task, but having memory issues. Needs some serious thought
    [task_display.c, task_display.h]
2025-10-09 something wrong is going on
    [task_display.c]
2025-10-15 Fixed pesky seg fault and made stack sizes more sensible
    [gui_main.c, main.c, programming_mode.c, task_lua_vm.c, task_usb_storage_device.c]
2025-10-17 next and prev buttons working
2025-11-09 fixed bug exiting lua too soon
    [gamepad_hid.c, task_lua_vm.c]
2025-11-12 keyboard input callback. Missing lots of keys needs work
    [task_lua_vm.c, task_spi_usb.c]
2025-11-13 fixed bug missing keys. Increased spi rate to 20mhz. 40mhz should be possible. Maybe the signal is bad? scope it out
    [ReMapper.c, task_lua_vm.c, task_spi_usb.c]
2025-11-13 issues with timing present
    [gamepad_hid.c, hid_q.c, hid_q.h, task_lua_vm.c, task_spi_usb.c]
2025-11-15 fixed custom file open
    [task_lua_vm.c]
2025-11-18 fixed bug with multi size mouse report. need to fix properly next time. Fix delays in mouse passthrough
    [hid_parsing.c, task_spi_usb.c]
2025-11-18 passthrough delay fixed, but recording still broken
    [gamepad_hid.c, task_lua_vm.c]
2025-12-03 starting to fix button mappings
    [task_lua_vm.c]
2025-12-17 started working on v5
    [EdgeCut1.dwg, ReMapper.kicad_pcb, ReMapper.kicad_sch, edge_cut_65x35.dxf, v5.dxf]
2025-12-17 perhaps good layout
    [ReMapper.kicad_pcb]
2025-12-18 dip switch, more layout fixes
    [219-4MST.step, ReMapper.kicad_pcb, ReMapper.kicad_sch]
2025-12-18 passing DRC
    [ReMapper.kicad_pcb, ReMapper.kicad_sch]
2025-12-23 sent to fab
    [ReMapper.kicad_pcb]
2026-01-06 cad files
    [screen_standoff.stl]
2026-01-06 re-nameing to HIDMorph
    [HIDMorph.kicad_pcb, HIDMorph.kicad_sch, ReMapper.kicad_pcb, ReMapper.kicad_sch, ReMapper.step, bom.csv, designators.csv, positions.csv]
2026-01-15 added assembly map and ibom
